apsteven/Dataport-Charge-Bay-Indicator/README.md

# Dataport-Charge-Bay-Indicator
Astromech Droid DataPort and Charge Bay Indicator Design Files
