apsteven/Dataport-Charge-Bay-Indicator/dataport_flatpack_layout2.jpg

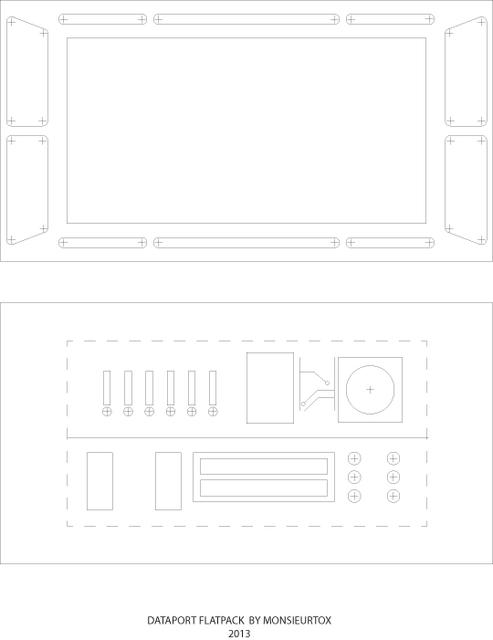
dataport_flatpack_layout2.jpg
