apsteven/Dataport-Charge-Bay-Indicator/PCBs/Charging Bay Indicators/CBI Bezel.jpg

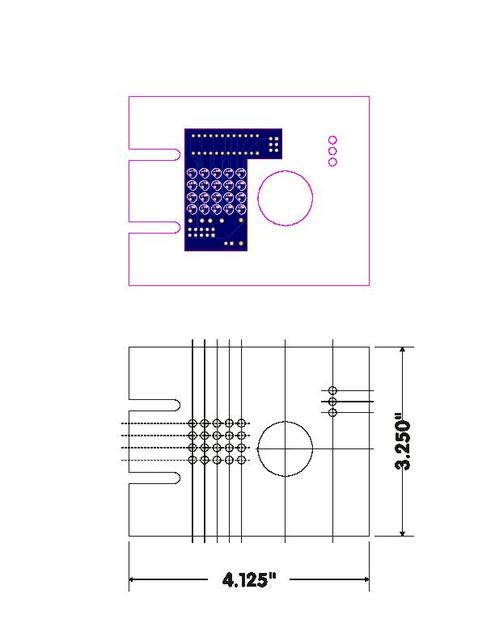
PCBs/Charging Bay Indicators/CBI Bezel.jpg
