apsteven/Dataport-Charge-Bay-Indicator/PCBs/Dataport/Data Panel Small Parts.dxf

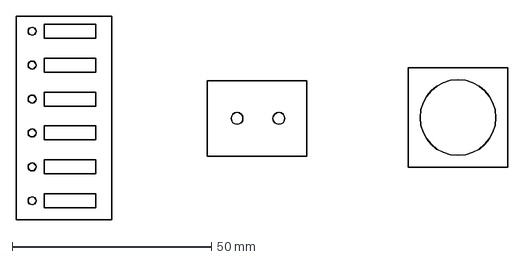
[picture p8: CAD file, 2019-11-01]
PCBs/Dataport/Data Panel Small Parts.dxf
123.3 x 51.0 mm
