apsteven/Dataport-Charge-Bay-Indicator/PCBs/Dataport/Data Panel Border.dxf

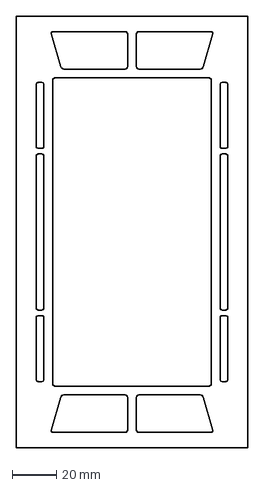
[picture p9: CAD file, 2019-11-01]
PCBs/Dataport/Data Panel Border.dxf
105.0 x 196.0 mm
