apsteven/Dataport-Charge-Bay-Indicator/PCBs/Dataport/Data Panel Back.dxf

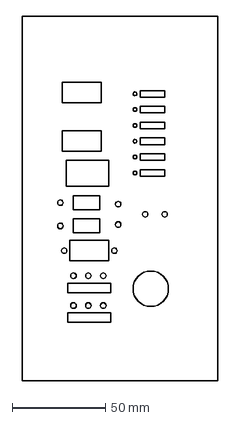
[picture p10: CAD file, 2019-11-01]
PCBs/Dataport/Data Panel Back.dxf
105.0 x 196.0 mm
